icl-rocketry/Ricardo-LightningMcQueen/README.md

# Engine-Electronics
Repository for all the Electronics for HyPNOS
