icl-rocketry/Ricardo-LightningMcQueen/Hardware/stock.xlsx

Component | Stock | Website
RSJ250P10TL | 10997 | Mouser
MCH6351 | 0 | Mouser, Digi-Key
Wurth Elektronik 7447709150 | 26554 | Mouser
