icl-rocketry/Ricardo-LightningMcQueen/Hardware/PDU.kicad_pcb

## KiCad design Hardware/PDU.kicad_pcb (2024-08-19)

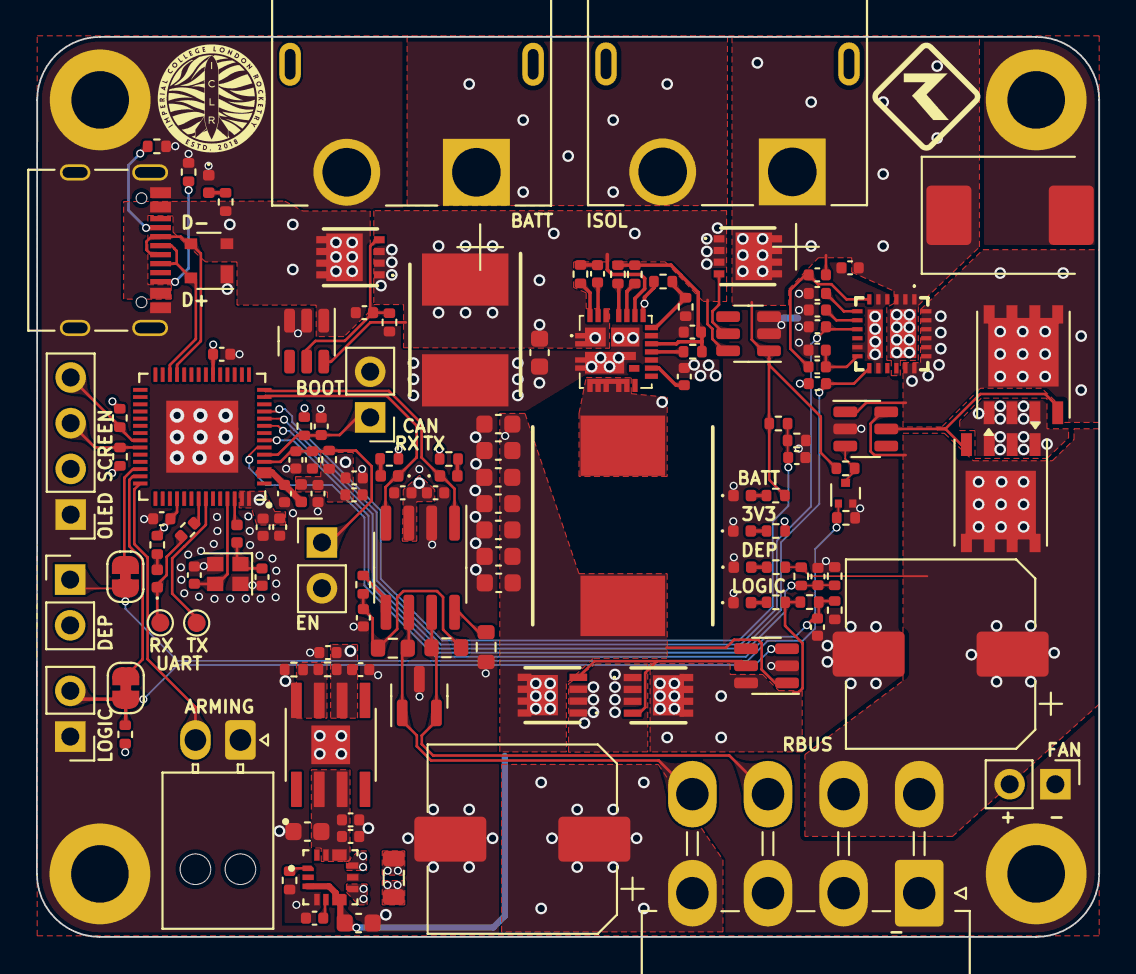
[picture p1: board PDU.kicad_pcb from above]

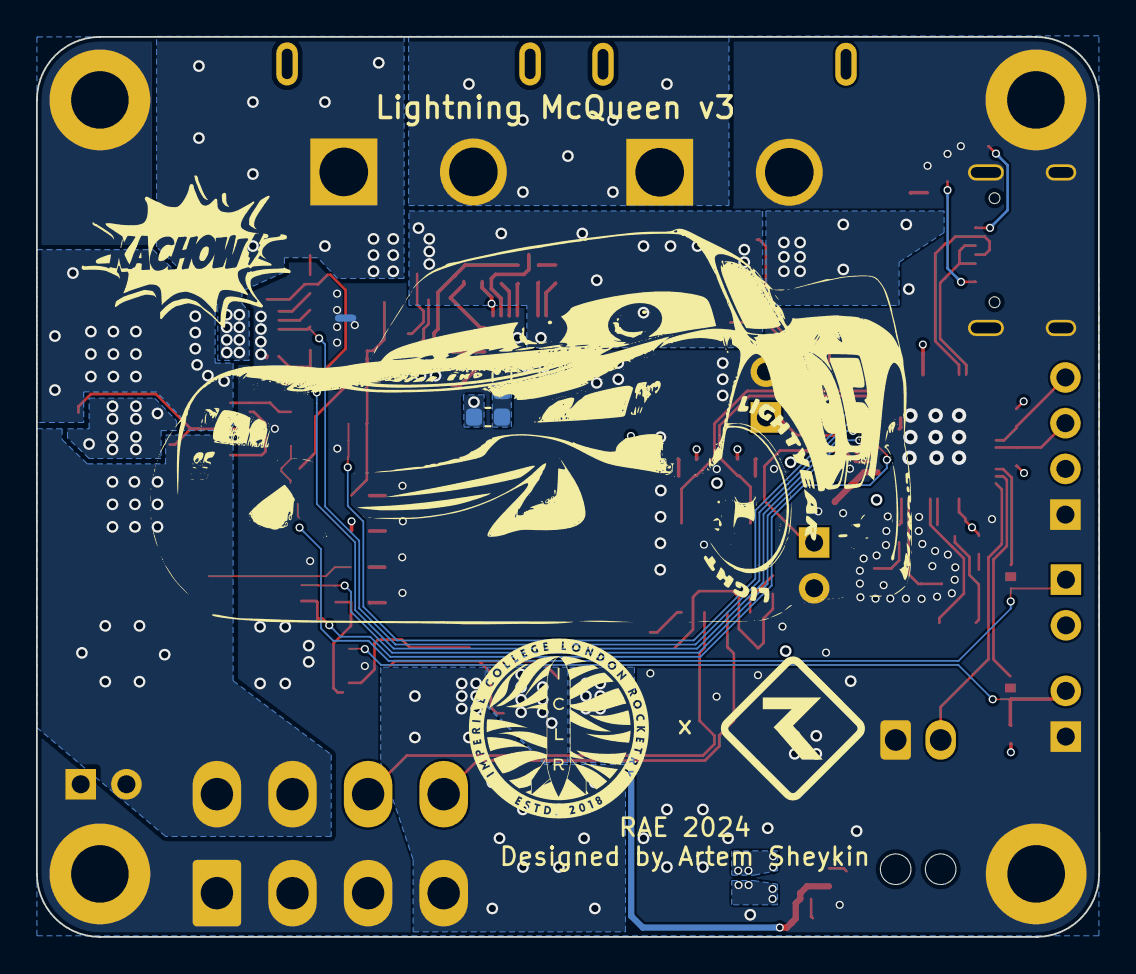
[picture p2: board PDU.kicad_pcb from below]

Board: 4 copper layers, 59.0 x 50.0 mm, 141 parts (2 on the bottom side), 78 nets.

Parts:
3V3LED1: CYAN_LED; LED_0402_1005Metric
BATTLED1: ORANGE_LED; LED_0402_1005Metric
BOOTJUMPER1: Conn_01x02_Male; PinHeader_1x02_P2.54mm_Vertical
C1, C19, C51, C53: 10uF; C_0402_1005Metric
C2, C4, C7, C46, C49: 1uF; C_0402_1005Metric
C3, C5, C6, C8, C10, C11, C26, C27, C28, C42, C54: 0.1uF; C_0402_1005Metric
C9, C22: 10nF; C_0402_1005Metric
C12: 2.2uF; C_0402_1005Metric
C13, C14: 11pF; C_0402_1005Metric
C15, C25, C30, C32, C34, C36, C38, C50: 22uF; C_0603_1608Metric
C16: TBD; C_0603_1608Metric
C17: 10uF; C_0603_1608Metric
C18: 100nF; C_0402_1005Metric
C20: 47nF; C_0402_1005Metric
C21: 4.7nF; C_0402_1005Metric
C23: 1000uF; CP_Elec_10x10
C24: 180uF; CP_Elec_10x10
C40: 100uF; CAPPM7362X200N
C44: 100nF; C_0603_1608Metric
C47, C52: 4.7uF; C_0402_1005Metric
CANRXLED1: ORANGE_LED; LED_0402_1005Metric
CANTXLED1: EMERALD_LED; LED_0402_1005Metric
D1: SP0503BAHT; SOT-143
D2: SM712_SOT23; SOT-23
D4: SMCJ24AHE3_A/H; D_SMC
DEPLED1: RED_LED; LED_0402_1005Metric
ENJUMPER1: Conn_01x02_Male; PinHeader_1x02_P2.54mm_Vertical
H1, H2, H3, H4: MountingHole_Pad; MountingHole_3.2mm_M3_DIN965_Pad
IC1: TPS259830ONRGER
IC2: SiC437AED-T1-GE3; SiC437BEDT1GE3
J1: Conn_01x03_MountingPin; Molex_Nano-Fit_105313-xx02_1x02_P2.50mm_Horizontal
J2: FAN; PinHeader_1x02_P2.54mm_Vertical
J3: USB_C_Receptacle_USB2.0; USB_C_Receptacle_Palconn_UTC16-G
J4, J6: Conn_01x02_Male; PinHeader_1x02_P2.54mm_Vertical
J5: Conn_01x08_Male; Molex_Mini-Fit_Jr_5569-08A2_2x04_P4.20mm_Horizontal
J7, J9: XT60PW-M; AMASS_XT60PW-M
J8: Conn_01x04_Male; PinHeader_1x04_P2.54mm_Vertical
JP1, JP2: SolderJumper_2_Bridged; SolderJumper-2_P1.3mm_Bridged_RoundedPad1.0x1.5mm
L1: 2.0nH; L_0402_1005Metric
L2: 20nH; L_0402_1005Metric
L3: SRP1050WA-3R3M; INDPM110100X540N
L5: 1uH; L_0805_2012Metric
LOGICLED1: BLUE_LED; LED_0402_1005Metric
Q1: SSM3K15AMFV,L3F; SOT-723
Q2, Q3: SI7635DP-T1-GE3; PowerPAK_SO-8_Single
Q5, Q6: PXP012-30QLJ; PXP01230QLJ
Q7, Q8: SQS141ELNW-T1_GE3; SQS850ENT1_GE3
R1: 14k; R_0402_1005Metric
R2: 56k; R_0402_1005Metric
R3, R6: 10K; R_0402_1005Metric
R4: 499; R_0402_1005Metric
R5, R7, R33: 470; R_0402_1005Metric
R8, R46: 2.2k; R_0402_1005Metric
R9, R27: 3k; R_0402_1005Metric
R10, R11, R12: 5.1k; R_0402_1005Metric
R13, R18, R21, R22, R25, R26, R32, R35: 10k; R_0402_1005Metric
R14, R28: 97.6k; R_0402_1005Metric
R15: 0; R_0603_1608Metric
R16, R17: 60; R_0603_1608Metric
R19, R34, R36: 1k; R_0402_1005Metric
R20: 45.3k; R_0402_1005Metric
R23: 0; R_0402_1005Metric
R24: 2.87k; R_0402_1005Metric
R29: 51k; R_0402_1005Metric
R30: 2.2; R_0402_1005Metric
R31, R47: 100k; R_0402_1005Metric
R37: TBD; R_0603_1608Metric
R38: 82; C_0402_1005Metric
R39: 1M; C_0402_1005Metric
R40: 732k; C_0402_1005Metric
R41: 73.2k; C_0402_1005Metric
R42: 680; C_0402_1005Metric
R43: 100k; C_0402_1005Metric
TP4, TP5: TestPoint; TestPoint_Pad_D1.0mm
TXLED1: GREEN_LED; LED_0402_1005Metric
U1, U6, U7, U8: LTC4412xS6; TSOT-23-6
U2: ESP32-S3; QFN40P700X700X90-57N
U4: MAX77827AEFD+T; CONV_MAX77827AEFD+T
U5: SN65HVD230; SOIC-8_3.9x4.9mm_P1.27mm
U10: SC4215; SOIC127P599X175-9N
USBLED1: WHITE_LED; LED_0402_1005Metric
Y1: 40MHz±10ppm; Crystal_SMD_2016-4Pin_2.0x1.6mm

Connections:
+3V3: C1.1, C4.1, C5.1, C7.1, C9.1, C10.1, C11.1, C18.1, C19.1, C53.2, C54.2, J6.2, J8.2, L1.1, R2.1, R3.1, R5.1, R6.1, R7.2, R8.1, R18.1, R19.1, R36.1, R43.1, R46.1, U2.20 (VDD3P3_RTC), U2.46 (VDD3P3_CPU), U2.55 (VDDA), U2.56 (VDDA), U5.3 (VCC), U10.6 (VOUT)
+12V: C22.2, D4.1 (K), IC1.1 (IN_1), IC1.2 (IN_2), IC1.3 (IN_3), IC1.16 (IN_4), IC1.25 (IN_5), J9.1 (+), Q5.5 (D_1), Q5.6 (D_2), Q5.7 (D_3), Q5.8 (D_4), Q5.9 (D_5), R9.1, R14.1, R35.2, R39.1, U1.1 (VIN)
/3V3Filter/BBOUT: C50.1, C51.1, C52.1, U4.11 (OUT), U4.13 (OUTS), U10.2 (EN), U10.3 (VIN)
/3V3Filter/BIAS: C49.1, U4.5 (BIAS)
/3V3Filter/FBIn: R2.2, R13.1, U10.7 (ADJ)
/3V3Filter/LX1: L5.1, U4.8 (LX1)
/3V3Filter/LX2: L5.2, U4.10 (LX2)
/3V3Filter/SEL: R1.1, U4.1 (SEL)
/ARMING: J1.2, U2.42 (GPIO37)
/BOOT: BOOTJUMPER1.1, C8.1, R6.2, U2.5 (GPIO0/BOOT)
/BattVoltage: C28.1, R14.2, R22.1, U2.11 (GPIO6/ADC1_CH5)
/Bucks/BOOT: C42.1, IC2.23 (BOOT)
/Bucks/FB: IC2.17 (FB), R20.1, R21.1
/Bucks/MODE_1: IC2.21 (_MODE_1), R29.2
/Bucks/MODE_2: IC2.20 (MODE_2), R31.1
/Bucks/PHASE: IC2.24 (PHASE), R30.1
/Bucks/SW: C16.1, IC2.5 (SW_1), IC2.6 (SW_2), IC2.7 (SW_3), IC2.8 (SW_4), IC2.9 (SW_5), IC2.30 (SW_6), L3.2
/Bucks/Vdd: C46.2, IC2.15 (VDD), R25.1, R29.1, R31.2
/CAN+: D2.2 (A2), J5.7, R16.1, U5.7 (CANH)
/CAN-: D2.1 (A1), J5.8, R17.2, U5.6 (CANL)
/CAN/Vref: R23.1, U5.5 (Vref)
/CAN_RX: CANRXLED1.1 (K), U2.13 (GPIO8/ADC1_CH7), U5.4 (R)
/CAN_TX: CANTXLED1.1 (K), U2.14 (GPIO9/ADC1_CH8), U5.1 (D)
/CHIP_PU: C2.1, C3.1, ENJUMPER1.1, R3.2, U2.4 (CHIP_PU/RESET)
/Data+: D1.4 (K), J3.A6 (D+), J3.B6 (D+), U2.26 (GPIO20/USB_D+/ADC2_CH9)
/Data-: D1.3 (K), J3.A7 (D-), J3.B7 (D-), U2.25 (GPIO19/USB_D-/ADC2_CH8)
/DepCurrent: IC1.9 (IMON), R42.1, U2.10 (GPIO5/ADC1_CH4)
/DepSwitch: JP1.1 (A), U2.40 (GPIO35)
/DepVoltage: C27.1, R28.2, R32.1, U2.7 (GPIO2/ADC1_CH1)
/EFuse_PG: IC1.13 (PG), R43.2, U2.9 (GPIO4/ADC1_CH3)
/LogicSwitch: JP2.2 (B), U2.41 (GPIO36)
/LogicVoltage: C26.1, R24.2, R26.1, U2.6 (GPIO1/ADC1_CH0)
/SCL: J8.3, R8.2, U2.37 (SPICLK_P/GPIO47)
/SDA: J8.4, R46.2, U2.36 (SPICLK_N/GPIO48)
/Switches+RBUS/CTL: Q1.3 (D), R35.1, U7.3 (CTL)
/Switches+RBUS/EFuse_OUT: IC1.17 (OUT_1), IC1.18 (OUT_2), IC1.19 (OUT_3), IC1.20 (OUT_4), IC1.21 (OUT_5), IC1.22 (OUT_6), IC1.23 (OUT_7), IC1.24 (OUT_8), Q2.5, U7.1 (VIN)
/Switches+RBUS/OVLO: IC1.12 (OVLO), R40.2, R41.1
/TXD: R4.1, TP4.1, TXLED1.1 (K)
GND: 3V3LED1.1 (K), BATTLED1.1 (K), BOOTJUMPER1.2, C1.2, C2.2, C3.2, C4.2, C5.2, C6.2, C7.2, C8.2, C9.2, C10.2, C11.2, C13.2, C14.2, C15.1, C17.2, C18.2, C19.2, C20.2, C21.1, C22.1, C23.2, C24.2, C25.1, C26.2, C27.2, C28.2, C30.1, C32.1, C34.1, C36.1, C38.1, C40.2, C44.2, C46.1, C47.2, C49.2, C50.2, C51.2, C52.2, C53.1, C54.1, D1.1 (A), D2.3 (common), D4.2 (A), DEPLED1.1 (K), ENJUMPER1.2, H1.1, H2.1, H3.1, H4.1, IC1.4 (GND_1), IC1.5 (GND_2), IC1.11 (NRETRY), IC1.14 (GND_3), IC1.26 (GND_4), IC2.3 (P_GND_1), IC2.4 (P_GND_2), IC2.13 (P_GND_3), IC2.16 (A_GND), IC2.25 (AGND), IC2.27 (PGND), IC2.29 (P_GND_4), J1.1, J2.1, J3.A1 (GND), J3.A12 (GND), J3.B1 (GND), J3.B12 (GND), J3.S1 (SHIELD), J4.1, J5.1, J5.2, J5.3, J7.2 (-), J8.1, LOGICLED1.1 (K), Q1.2 (S), R1.2, R10.2, R11.1, R13.2, R15.2, R21.2, R22.2, R26.2, R32.2, R34.1, R37.2, R38.2, R41.2, R42.2, R47.2, U1.2 (GND), U1.3 (CTL), U2.57 (GND), U4.4 (AGND), U4.9 (PGND), U5.2 (GND), U6.2 (GND), U7.2 (GND), U8.2 (GND), U8.3 (CTL), U10.8 (GND), U10.9 (GND), USBLED1.1 (K), Y1.2, Y1.4
unnamed: 3V3LED1.2 (A), R7.1
unnamed: BATTLED1.2 (A), R9.2
unnamed: C6.1, L1.2, U2.2 (VDD3P3), U2.3 (VDD3P3)
unnamed: C14.1, L2.2, Y1.1
unnamed: C16.2, R37.1
unnamed: C20.1, R16.2, R17.1, R23.2
unnamed: C42.2, R30.2
unnamed: CANRXLED1.2 (A), R36.2
unnamed: CANTXLED1.2 (A), R19.2
unnamed: DEPLED1.2 (A), R27.2
unnamed: IC1.6 (EN/UVLO), R39.2, R40.1
unnamed: IC1.8 (ILIM), R38.1
unnamed: C21.2, IC1.7 (ITIMER)
unnamed: C40.1, C44.1, IC2.1 (V_IN_1), IC2.2 (V_IN_2), IC2.19 (EN), IC2.22 (VIN_1), IC2.26 (VIN_2), Q5.1 (S_1), Q5.2 (S_2), Q5.3 (S_3), Q6.1 (S_1), Q6.2 (S_2), Q6.3 (S_3), U1.6 (SENSE), U8.6 (SENSE)
unnamed: IC2.14 (P_GOOD), R25.2
unnamed: C47.1, IC2.12 (V_DRV)
unnamed: C24.1, J2.2, J5.5, J5.6, Q3.5, R27.1, R28.1, U7.6 (SENSE)
unnamed: J3.A5 (CC1), R10.1
unnamed: J3.B5 (CC2), R11.2
unnamed: J4.2, JP2.1 (A), R18.2, U6.3 (CTL)
unnamed: C23.1, J5.4, Q8.5 (D_1), Q8.6 (D_2), Q8.7 (D_3), Q8.8 (D_4), Q8.9 (D_5), Q8.10 (D_6), Q8.11 (D_7), R24.1, R33.2, U6.6 (SENSE)
unnamed: J6.1, JP1.2 (B), Q1.1 (G), R34.2
unnamed: J7.1 (+), J9.2 (-)
unnamed: LOGICLED1.2 (A), R33.1
unnamed: Q2.1, Q2.2, Q2.3, Q3.1, Q3.2, Q3.3
unnamed: Q5.4 (G), U1.5 (GATE)
unnamed: C12.2, Q6.4 (G), R47.1, U8.5 (GATE)
unnamed: Q7.4 (G), Q8.4 (G), U6.5 (GATE)
unnamed: Q7.1 (S_1), Q7.2 (S_2), Q7.3 (S_3), Q8.1 (S_1), Q8.2 (S_2), Q8.3 (S_3)
unnamed: R5.2, TXLED1.2 (A)
unnamed: TP5.1, U2.50 (U0RXD/PROG/GPIO44)
unnamed: R4.2, U2.49 (U0TXD/PROG/GPIO43)
unnamed: C13.1, U2.53 (XTAL_N), Y1.3
unnamed: L2.1, U2.54 (XTAL_P)
unnamed: R15.1, U5.8 (Rs)
unnamed: Q2.4, Q3.4, U7.5 (GATE)
unnamed: R12.2, USBLED1.2 (A)
RBUS_uC_V: C15.2, C17.1, C25.2, C30.2, C32.2, C34.2, C36.2, C38.2, IC2.18 (V_OUT), L3.1, Q7.5 (D_1), Q7.6 (D_2), Q7.7 (D_3), Q7.8 (D_4), Q7.9 (D_5), Q7.10 (D_6), Q7.11 (D_7), R20.2, U4.3 (EN), U4.6 (IN), U6.1 (VIN)
VBUS: C12.1, D1.2 (K), J3.A4 (VBUS), J3.A9 (VBUS), J3.B4 (VBUS), J3.B9 (VBUS), Q6.5 (D_1), Q6.6 (D_2), Q6.7 (D_3), Q6.8 (D_4), Q6.9 (D_5), R12.1, U8.1 (VIN)
