icl-rocketry/Ricardo-LightningMcQueen/Firmware/src/Powerrail/powerrail.cpp

#include "powerrail.h"
#include "Config/pinmap_config.h"
#include <libriccore/riccorelogging.h>
#include <Arduino.h>

#include <string>

#include <driver/gpio.h>
#include <driver/adc.h>
#include <esp_adc_cal.h>
#include <esp32-hal-adc.h>


void PowerRail::RailSetup(uint16_t maxVoltage, uint16_t minVoltage){

    pinMode(_control_pin, OUTPUT);
    pinMode(_voltage_pin, INPUT_PULLDOWN);

    //the logic on the logic and dep rails is reversed so couldnt think of a better way of doing this
    if (_high_is_rail_on){
        ON_state = HIGH;
        OFF_state = LOW;
    }
    else {
        ON_state = LOW;
        OFF_state = HIGH;
    }


    if (_on_at_startup == true){
        RailOn();    
    }
    if (_on_at_startup == false){
        RailOff();
    }


    _maxVoltage = maxVoltage;
    _minVoltage = minVoltage;

    int error = 0;
    //get channel and adc unit
    int8_t channel = digitalPinToAnalogChannel(_voltage_pin);
    if (channel > (SOC_ADC_MAX_CHANNEL_NUM - 1))
    {
        _channel = static_cast<adc_channel_t>(channel-SOC_ADC_MAX_CHANNEL_NUM);
        _unit = ADC_UNIT_2;
        
        error += adc2_config_channel_atten(static_cast<adc2_channel_t>(_channel),_atten);
    }

    

    else
    {
        _channel = static_cast<adc_channel_t>(channel);
        _unit = ADC_UNIT_1;
        error += adc1_config_width(_width);
        error += adc1_config_channel_atten(static_cast<adc1_channel_t>(_channel),_atten);
    }

    if (error)
    {
        //RicCoreLogging::log<RicCoreLoggingConfig::LOGGERS::SYS>("Vrail Monitor Failed to initialize!");
        return;
    }

    //characerise ADC
    esp_adc_cal_characterize(_unit,_atten,_width,1100,&_adcCal);

    _adcInitialized = true;

}

void PowerRail::RailOn(){
    digitalWrite(_control_pin, ON_state);

}

void PowerRail::RailOff(){
    digitalWrite(_control_pin, OFF_state);
}


void PowerRail::RailRestart(uint32_t delay){
    _delay = delay;
    restart = true;
    time_restart_started = millis();
}

void PowerRail::RailUpdate(){

    // restarting logic rail
    if (restart){
        RailOff();
        if (millis() - time_restart_started > _delay){
            RailOn();
            restart = false;
        }
    }

    RailMonitoringUpdate();
}


void PowerRail::RailMonitoringUpdate(){

    // rail monitoring stuff
    if(!_adcInitialized)
    {
        return;
    }

    if (millis() - prevSampleTime >= sampleDelta)
    {   
        int raw_reading;
        if (_unit == ADC_UNIT_1)
        {
            raw_reading = adc1_get_raw(static_cast<adc1_channel_t>(_channel));
        }
        else
        {
            
             adc2_get_raw(static_cast<adc2_channel_t>(_channel),_width,&raw_reading);
        }

        uint32_t reading = esp_adc_cal_raw_to_voltage(raw_reading,&_adcCal);

        data.volt = (uint16_t)(factor * (float)reading); // voltage in mV
        
        if (!_maxVoltage)
        {
            //cannot calculate if we dont have max voltage
            data.percent = 0;
        }
        else
        {
            data.percent = uint16_t(((float)(data.volt - _minVoltage) / (float)(_maxVoltage - _minVoltage)) * 100.0);
        }
    }

}

RailStruct::rail_data PowerRail::getData()
{
    return data;
}
