icl-rocketry/Ricardo-LightningMcQueen/(commit log)

2021-12-04 Initial rev of e-match board (adapted from sensorboard schematic)
    Replaced all the ADCs with 4 e-match circuits
    [AMCA31-2R450G-S1F-T3.step, IMU.sch, Mainboard.kicad_pcb, Mainboard.sch, Nukes.sch, analogue.sch, analogueI2C.sch, ematch.sch]
2021-12-04 Revert "Jiawei yao 2022 patch 1"
    [AMCA31-2R450G-S1F-T3.step, IMU.sch, Mainboard.kicad_pcb, Mainboard.sch, Nukes.sch, Ricardo_Nov_7_larger_usb_c.sch, analogue.sch, analogueI2C.sch]
2022-01-29 Added work so far
    [3.sch, battchrg.sch, power_new_25012022.sch]
2022-01-29 Updates changes 29/01/2022
    [3.sch]
2022-02-08 08/02/2022 start
    [power_new_25012022.sch]
2022-02-08 08/02/2022 update
    [3.sch]
2022-02-08 08/02/2022
    3.3v regulators complete
    [3.sch]
2022-02-08 08/02/2022 update3
    [battchrg.sch, power_new_25012022.sch]
2022-02-08 reverse polarity protection
    [3.sch, battchrg.sch, power_new_25012022.sch]
2022-02-13 13/02/2022
    reverse polarity protection added, some test points, general clear up
    [3.sch]
2022-02-19 added lpc/24 enable
    [battchrg.sch, power_new_25012022.sch]
2022-02-22 kicad6 file
    [3.kicad_sch, battchrg.kicad_sch, power_new_25012022.kicad_sch]
2022-02-22 Tidy up Kicad 6
    [3.sch, battchrg.kicad_sch, battchrg.sch, power_new_25012022.sch]
2022-02-26 usb --> uart connection added
    [battchrg.kicad_sch, power_new_25012022.kicad_sch, untitled.kicad_sch]
2022-02-26 Sorted Labels
    [powerboard_sc21_as25.kicad_sch]
2022-02-26 added vbus to 3.3v converter
    [battchrg.kicad_sch, powerboard_sc21_as25.kicad_sch, untitled.kicad_sch]
2022-03-01 Checked the values for battery monitor
    [battchrg.kicad_sch, powerboard_sc21_as25.kicad_sch]
2022-03-05 Added thermistor resistor for specific thermistor
    [battchrg.kicad_sch, powerboard_sc21_as25.kicad_sch, redundantreg.kicad_sch, usb__uart.kicad_sch]
2022-03-08 isolation switch added
    [battchrg.kicad_sch, powerboard_sc21_as25.kicad_sch]
2022-03-25 removed battery monitor
    [battchrg.kicad_sch, battmonitor.kicad_sch, powerboard_sc21_as25.kicad_sch]
2022-05-24 Added connectors and potential divider for charge measurement
    [battchrg.kicad_sch, powerboard_sc21_as25.kicad_sch]
2022-05-24 Swapped remaining p mosfets
    [powerboard_sc21_as25.kicad_sch]
2022-06-04 removed charger reverse polarity protection
    [battchrg.kicad_sch, powerboard_sc21_as25.kicad_pcb, powerboard_sc21_as25.kicad_sch, redundantreg.kicad_sch, usb__uart.kicad_sch]
2022-06-04 changed old mosfets, broke out I2C
    [battchrg.kicad_sch, powerboard_sc21_as25.kicad_sch, redundantreg.kicad_sch, usb__uart.kicad_sch]
2022-06-10 3v3 reg cap & inductor changes, added boost capacitor
    [battchrg.kicad_sch, powerboard_sc21_as25.kicad_sch, redundantreg.kicad_sch, usb__uart.kicad_sch]
2022-06-10 assigned FPs for ceramic caps & most resistors
    [battchrg.kicad_sch, powerboard_sc21_as25.kicad_sch, redundantreg.kicad_sch, usb__uart.kicad_sch]
2022-06-14 added components spreadsheet, changed some caps to ceramic
    [battchrg.kicad_sch, components.xlsx, powerboard_sc21_as25.kicad_sch]
2022-06-14 actually changed caps this time
    [battchrg.kicad_sch, powerboard_sc21_as25.kicad_sch, redundantreg.kicad_sch, usb__uart.kicad_sch]
2022-06-18 All capacitors selected, most other footprints assigned
    [battchrg.kicad_sch, components.xlsx, powerboard_sc21_as25.kicad_sch, redundantreg.kicad_sch, usb__uart.kicad_sch]
2022-06-18 Finished footprint assignment
    [battchrg.kicad_sch, powerboard_sc21_as25.kicad_sch, redundantreg.kicad_sch, usb__uart.kicad_sch]
2022-06-18 changed some FP assignments and imported components
    [battchrg.kicad_sch, powerboard_sc21_as25.kicad_pcb, powerboard_sc21_as25.kicad_sch, redundantreg.kicad_sch]
2022-06-21 grouped components by circuit, done CAN transceiver layout.
    [powerboard_sc21_as25.kicad_pcb, powerboard_sc21_as25.kicad_sch, usb__uart.kicad_sch]
2022-06-27 Tuesday's changes (I don't remember what I did)
    [powerboard_sc21_as25.kicad_pcb]
2022-06-28 Finalised buck capacitors, some inital layout
    [components.xlsx, powerboard_sc21_as25.kicad_pcb, powerboard_sc21_as25.kicad_sch, redundantreg.kicad_sch]
2022-06-28 moving around charger components
    [battchrg.kicad_sch, powerboard_sc21_as25.kicad_pcb]
2022-07-04 changed isolation switch position
    [powerboard_sc21_as25.kicad_pcb]
2022-07-04 started routing, mess at the moment
    [powerboard_sc21_as25.kicad_pcb]
2022-07-06 change some passive values and slight FP changes after orderlist
    some resistor values were really unconventional and some cap footprints had gone out of stock so had to change them.
    [battchrg.kicad_sch, powerboard_sc21_as25.kicad_sch, redundantreg.kicad_sch, usb__uart.kicad_sch]
2022-07-06 forgot to stage the footprint info file
2022-07-06 layout progress
    [battchrg.kicad_sch, powerboard_sc21_as25.kicad_pcb, powerboard_sc21_as25.kicad_sch, usb__uart.kicad_sch]
2022-07-07 Fixed USB data pins
    [powerboard_sc21_as25.kicad_sch, usb__uart.kicad_sch]
2022-07-07 Changed some values and footprints since some went out of stock
    [battchrg.kicad_sch, powerboard_sc21_as25.kicad_sch, redundantreg.kicad_sch, usb__uart.kicad_sch]
2022-07-08 Change RSR and RAC sense resistor to ones rated for 5W
    [battchrg.kicad_sch, powerboard_sc21_as25.kicad_sch]
2022-07-08 changed RSR again
    [battchrg.kicad_sch, powerboard_sc21_as25.kicad_sch]
2022-07-08 update 2
    [powerboard_sc21_as25.kicad_pcb, powerboard_sc21_as25.kicad_sch]
2022-07-08 changed RSR traces to same layer
    going to check charger layout recommendations again
    [powerboard_sc21_as25.kicad_pcb]
2022-07-10 Andrei's review, no via fencing on ufl conn
    [powerboard_sc21_as25.kicad_pcb]
2022-07-11 corrected based on bq24618 guidelines as much as possible
    [powerboard_sc21_as25.kicad_pcb]
2022-07-14 Removed CAN resistors
    [powerboard_sc21_as25.kicad_pcb, powerboard_sc21_as25.kicad_sch]
2022-07-17 Added connector for PDU EN pin and external LED + routing changes
    [powerboard_sc21_as25.kicad_pcb, powerboard_sc21_as25.kicad_sch]
2022-07-19 silkscreen tidying
    [powerboard_sc21_as25.kicad_pcb]
2022-07-23 swapping mosfets the right way around
    [battchrg.kicad_sch, powerboard_sc21_as25.kicad_pcb, redundantreg.kicad_sch]
2022-07-23 super small adjustment
    [powerboard_sc21_as25.kicad_pcb]
2022-07-27 dan's review
    [battchrg.kicad_sch, powerboard_sc21_as25.kicad_pcb, powerboard_sc21_as25.kicad_sch, redundantreg.kicad_sch]
2022-07-28 written some software
    [battchrg.kicad_sch, battmonitor.kicad_sch, components.xlsx, powerboard_sc21_as25.kicad_pcb, powerboard_sc21_as25.kicad_sch, redundantreg.kicad_sch, ricpart.csv, usb__uart.kicad_sch]
2022-07-28 Fixed pin assignments
    [powerboard_sc21_as25.kicad_pcb, powerboard_sc21_as25.kicad_sch]
2022-07-29 Fixed file location and changed a trace width
    [battchrg.kicad_sch, powerboard_sc21_as25.kicad_pcb, powerboard_sc21_as25.kicad_sch, redundantreg.kicad_sch]
2022-07-29 Added PCB name on back silkscreen + version numbering
    [powerboard_sc21_as25.kicad_pcb]
2022-07-29 did some final fixes with track width
    [powerboard_sc21_as25.kicad_pcb]
2022-07-29 changed can h and i2c lines so vias are more conssitent
    [powerboard_sc21_as25.kicad_pcb]
2022-07-29 made can h and can l lines closer in length
    [powerboard_sc21_as25.kicad_pcb]
2022-07-29 battery cmds
2022-07-29 Auto stash before merge of "power-board" and "origin/power-board"
2022-07-30 Added Battery Commands
2022-08-01 re-layed out pdu to improve buck smps stability
    [battchrg.kicad_sch, powerboard_sc21_as25.kicad_pcb, powerboard_sc21_as25.kicad_sch, usb__uart.kicad_sch]
2022-08-01 Added 3v3 LED, changed LED labels on silkscreen, added Kachow
    [powerboard_sc21_as25.kicad_pcb, powerboard_sc21_as25.kicad_sch]
2022-08-03 Changed input filter resistors and changed layout to match
    [battchrg.kicad_sch, powerboard_sc21_as25.kicad_pcb, powerboard_sc21_as25.kicad_sch]
2022-08-25 updated pins and new layout
    [BOM-powerboard_sc21_as25.csv, battchrg.kicad_sch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]
2022-09-04 battVoltage reading pin changed to 14
2022-11-19 new board
    [3v3bucks.kicad_sch, BOM-powerboard_sc21_as25.csv, Switcher.kicad_pcb, Switcher.kicad_sch, battchrg.kicad_sch, battmonitor.kicad_sch, can.kicad_sch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]
2023-02-07 added power rail logging
    [Switcher.kicad_pcb, Switcher.kicad_sch]
2023-02-25 waiting for review
    [Switcher.csv, Switcher.kicad_pcb, Switcher.kicad_sch, Switcher.xlsx, can.kicad_sch, switches.kicad_sch, untitled.kicad_sch, usb-uart.kicad_sch]
2023-03-04 changed nanofits for pin headers, made space for usb casing
    [Switcher.kicad_pcb, Switcher.kicad_sch, switches.kicad_sch]
2023-03-04 fixed board setup
    [Switcher.kicad_pcb]
2023-03-09 i2c breakout, general clean up
    [3v3bucks.kicad_sch, Switcher.kicad_pcb, Switcher.kicad_sch, can.kicad_sch, switches.kicad_sch, untitled.kicad_sch, usb-uart.kicad_sch]
2023-03-28 vias fixed, ready for review
    [3v3bucks.kicad_sch, Switcher.kicad_pcb, Switcher.kicad_sch, can.kicad_sch, switches.kicad_sch]
2023-04-09 kiran/andrei review
    [3v3bucks.kicad_sch, Switcher.kicad_pcb, Switcher.kicad_sch, usb-uart.kicad_sch]
2023-04-09 rxd/txd testpoints
    [Switcher.kicad_pcb, Switcher.kicad_sch]
2023-05-18 mosfet flipping
    [Switcher.kicad_pcb, switches.kicad_sch]
2023-05-20 removed 100nf cap, pgood pull up
    [3v3bucks.kicad_sch, Switcher.kicad_pcb]
2023-05-28 3v3logging moved to buck output
    [3v3bucks.kicad_sch, Switcher.kicad_pcb, Switcher.kicad_sch, switches.kicad_sch]
2023-06-04 vias under limit, added via to gnda on bb
    [Switcher.kicad_pcb]
2023-07-01 usbpwr via intersect fix
    [Switcher.kicad_pcb]
2023-07-02 new layout
    [3v3filter.kicad_sch, Switcher.kicad_pcb, Switcher.kicad_sch]
2023-07-02 fixed cap in wrong place
    [Switcher.kicad_pcb]
2023-07-05 new inductor, logging traces rerouted
    [3v3bucks.kicad_sch, Switcher.kicad_pcb, Switcher.kicad_sch]
2023-07-13 order changes + gerbs
    [Switcher.kicad_pcb, bom.csv, designators.csv, positions.csv]
2023-07-15 Removed submodule Powerboard/Software/lib/librnp
2023-07-15 had to delete all the stuff in the software folder, dont know wahts going on
    [ricpart.csv]
2023-07-15 Ricardo-OS-Tempalte copied into software folder without components
    [ricpart.csv]
2023-07-17 deleted everything
    [ricpart.csv]
2023-07-17 copy of ricardo-os-template
    [ricpart.csv]
2023-08-08 Removed submodule Powerboard/Software/components/arduino-esp32
2023-08-09 added some commands, hardware fixes
    [3v3bucks.kicad_sch, PDU.csv, PDU.kicad_pcb, PDU.kicad_sch, PDU.xlsx, switches.kicad_sch]
2023-08-13 firmware updates
    [3v3bucks.kicad_sch, 3v3filter.kicad_sch, PDU.kicad_pcb, PDU.kicad_sch, can.kicad_sch, switches.kicad_sch, usb.kicad_sch]
2023-08-19 hardware update
    [PDU.kicad_pcb]
2023-08-22 data lines fix
    [PDU.kicad_pcb, redundantreg.kicad_sch, usb-uart.kicad_sch, usb__uart.kicad_sch]
2023-09-03 can hardware fix, firmware updates
    [PDU.kicad_pcb, PDU.kicad_sch, switches.kicad_sch]
2023-09-05 v2.1 ordering
    [3v3bucks.kicad_sch, 3v3filter.kicad_sch, PDU.kicad_pcb, PDU.kicad_sch, bom.csv, designators.csv, positions.csv, switches.kicad_sch]
2023-09-05 3D stuff
    [PDU.kicad_pcb]
2023-09-07 added RC snubber
    [3v3bucks.kicad_sch, PDU.kicad_pcb, bom.csv, designators.csv, positions.csv]
2024-06-10 v2.2 hardware
    [3v3bucks.kicad_sch, 3v3filter.kicad_sch, PDU.kicad_pcb, PDU.kicad_sch, can.kicad_sch, ricpart.csv, switches.kicad_sch, untitled.kicad_sch]
2024-07-20 commit before trying to squish the layout
    [PDU.kicad_pcb, PDU.kicad_sch, switches.kicad_sch]
2024-07-25 shiven layout change
    [3v3bucks.kicad_sch, PDU.kicad_pcb, PDU.kicad_sch, switches.kicad_sch]
2024-07-29 added rc on gates, post kiran review
    [PDU.kicad_pcb, switches.kicad_sch]
2024-07-30 fixed resistor value
    [3v3bucks.kicad_sch, PDU.kicad_pcb, switches.kicad_sch]
2024-07-30 updated mpn on some caps
    [3v3bucks.kicad_sch, PDU.kicad_pcb, switches.kicad_sch]
2024-08-05 changes post 3rd review
    [PDU.kicad_pcb, PDU.kicad_sch]
2024-08-13 esp32 adc cap was in wrong place
    [PDU.kicad_pcb, PDU.kicad_sch, switches.kicad_sch]
2024-08-16 post Andrei review
    [3v3bucks.kicad_sch, PDU.kicad_pcb, PDU.kicad_sch, switches.kicad_sch]
2024-08-18 moved efuse upstream of ltc
    [PDU.kicad_pcb, switches.kicad_sch]
2024-08-19 final review
    [PDU.kicad_pcb]
2024-08-21 repo cleanup
    [ricpart.csv]
2024-08-21 changed arduino branch
2024-09-27 fixed dep rail logic being backwards, battV in packet not being updated, and added a fix for the i2c oled causing lag
    [oledscreen.cpp, oledscreen.h, system.cpp]
2025-08-14 Fixed submodules for last v3 commit
    [app3M_fat9M_16MB.csv, bare_minimum_2MB.csv, default.csv, default_16MB.csv, default_8MB.csv, default_ffat.csv, ffat.csv, huge_app.csv]
2025-08-15 Updated to newest idf version
    [ricparts3.csv]
2025-08-15 correctly updated adc params for >idf5.0
    [powerrail.h, system.cpp]
